bdaad/posturography/README.md

# Posturography

ESP32 と 4 個の AD7193 から、重心動揺計の 4 チャンネル生データを取得するためのコード一式です。  
装置側では `ch1,ch2,ch3,ch4` 形式の CSV 行を出力し、PC 側ではサンプリング確認と校正用データ取得を行います。

## 目次

- [Posturography](#posturography)
  - [目次](#目次)
  - [構成](#構成)
  - [基板画像](#基板画像)
  - [装置側コード](#装置側コード)
  - [Arduino ファイルと通信方式](#arduino-ファイルと通信方式)
  - [データ受信方法](#データ受信方法)
    - [VS Code で見る](#vs-code-で見る)
    - [Arduino IDE で見る](#arduino-ide-で見る)
    - [Python で見る](#python-で見る)
    - [Bluetooth で見る](#bluetooth-で見る)
    - [BLE で受信する](#ble-で受信する)
  - [Python 環境](#python-環境)
  - [サンプリング確認](#サンプリング確認)
  - [校正手順](#校正手順)
  - [校正スクリプトの出力](#校正スクリプトの出力)
  - [校正後の確認](#校正後の確認)
  - [重心位置計算について](#重心位置計算について)
  - [トラブルシュート](#トラブルシュート)
    - [COM ポートが表示されない](#com-ポートが表示されない)
    - [データが取得できない](#データが取得できない)
    - [校正結果が不安定](#校正結果が不安定)

## 構成

| パス | 内容 |
| --- | --- |
| `ad7193_wired/ad7193_wired.ino` | USB シリアルで 4 チャンネルの AD7193 生コードを送信する ESP32 用スケッチ |
| `ad7193_wireless/ad7193_wireless.ino` | USB シリアルに加えて Bluetooth Classic SPP でも同じ CSV 行を送信する ESP32 用スケッチ |
| `BLE_ad7193/BLE_ad7193.ino` | `BLEDevice.h` を使って BLE Notify で AD7193 データを送信する ESP32 用スケッチ |
| `BLE_ad7193/ble_receive.py` | BLE Notify を受信して CSV 保存する Python スクリプト |
| `BLE_ad7193/ble_sampling_test.py` | BLE Notify の受信サンプリングレートを確認する Python スクリプト |
| `BLE_ad7193/README.md` | BLE 版の使い方 |
| `sampling_test.py` | シリアル受信のサンプル数を 1 秒ごと、10 秒ごとに表示する確認用スクリプト |
| `circuit.png` | 配線・回路の参考画像 |
| `calibration/calibration.py` | 校正用に一定数のサンプルを取得し、CSV、統計 JSON、サマリ TXT、ヒストグラム PNG を保存するスクリプト |
| `calibration/calibration.xlsx` | 各重量の `Baseline median` を入力して、各センサーの校正式を作るための Excel ファイル |
| `calibration/README.md` | 校正フォルダ単体で参照するための詳細 README |
| `calibration/calibration.png` | 校正に関する参考画像 |

## 基板画像

配線・回路を確認するときは、以下の基板画像を参照してください。

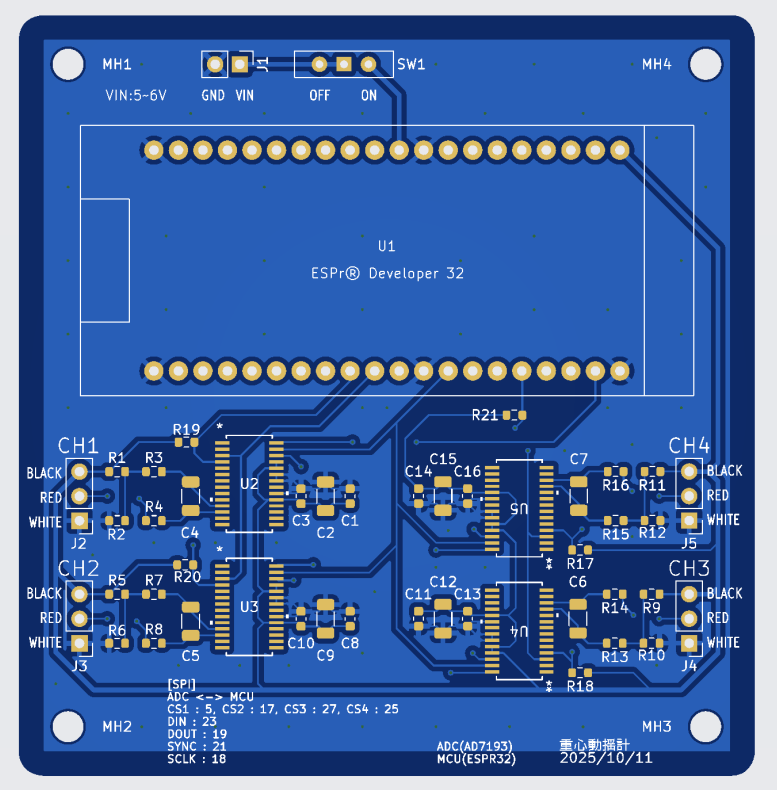
[picture p1: circuit.png]
基板画像


## 装置側コード

基本の校正では `ad7193_wired/ad7193_wired.ino` を使用します。  
Bluetooth Classic SPP で受信したい場合は `ad7193_wireless/ad7193_wireless.ino`、BLE で受信したい場合は `BLE_ad7193/BLE_ad7193.ino` を ESP32 に書き込みます。

共通の主な設定は以下です。

- ボーレート: `115200`
- 出力形式: `ch1,ch2,ch3,ch4`
- AD7193: 4 チップ構成
- AD7193 の目標データレート: 約 `100.1 Hz`
- SPI: `1 MHz`, `MODE3`
- ESP32 側ピン:
  - `MISO`: 19
  - `MOSI`: 23
  - `SCLK`: 18
  - `SYNC`: 21
  - `CS1`: 5
  - `CS2`: 17
  - `CS3`: 27
  - `CS4`: 25

`ad7193_wireless.ino` は Bluetooth Classic SPP のデバイス名 `ESP32-AD7193` で起動します。PC やスマートフォンから Bluetooth SPP として接続すると、USB シリアルと同じ CSV 行を受信できます。  
`BLE_ad7193.ino` は BLE デバイス名 `ESP32-AD7193-BLE` で起動します。BLE は COM ポートではなく、`BLE_ad7193/ble_receive.py` で Notify を受信します。

## Arduino ファイルと通信方式

今後 Arduino 側コードが増える可能性があるため、PC 側スクリプトと対応する `.ino` はここで確認してください。  
現在の対応は以下です。

| Arduino ファイル | 通信方式 | 校正での使用 | `sampling_test.py` | `calibration.py` | 手動確認 |
| --- | --- | --- | --- | --- | --- |
| `ad7193_wired/ad7193_wired.ino` | USB シリアル | 推奨 | 対応 | 対応 | Arduino IDE / VS Code のシリアルモニターで確認可能 |
| `ad7193_wireless/ad7193_wireless.ino` | USB シリアル + Bluetooth Classic SPP | USB 接続なら使用可能。Bluetooth は確認向け | 対応 | OS が Bluetooth SPP をシリアルポートとして認識すれば使用可能 | Arduino IDE / VS Code / Bluetooth SPP 対応アプリで確認可能 |
| `BLE_ad7193/BLE_ad7193.ino` | USB シリアル + BLE Notify | BLE は確認・開発向け。安定した校正は USB 推奨 | USB シリアル出力は確認可能 | BLE 入力は非対応。USB シリアル出力なら既存方式で確認可能 | USB Serial は Arduino IDE / VS Code、BLE は `BLE_ad7193/ble_receive.py` で確認 |

校正では通信の安定性を優先するため、基本は `ad7193_wired/ad7193_wired.ino` を ESP32 に書き込み、USB シリアルで取得してください。  
`ad7193_wireless/ad7193_wireless.ino` は Bluetooth Classic SPP の確認、`BLE_ad7193/BLE_ad7193.ino` は BLE Notify の確認や開発に使えます。

USB シリアルと Bluetooth Classic SPP の受信データの基本形式は同じです。

```text
ch1,ch2,ch3,ch4
```

起動直後は `AD7193 ID` や `AD7193 MODE` などのデバッグ行も出ます。  
`calibration.py` は `4 つの整数がカンマ区切りになっている行` だけをデータとして使い、デバッグ行は無視します。

BLE 版は Notify payload を 20 byte に収めるため、BLE 通知だけは `sample_index,DAT1,DAT2,DAT3,DAT4` 相当の little-endian `uint32` x 5 のバイナリフレームで送信します。`BLE_ad7193/ble_receive.py` が CSV に変換します。

## データ受信方法

最初は Python を動かす前に、シリアルモニターでデータが見えるか確認すると安全です。  
速度設定は `115200 bps` にします。

### VS Code で見る

1. VS Code に `Serial Monitor` 拡張機能を入れる。
2. ESP32 を USB ケーブルで PC に接続する。
3. VS Code の Serial Monitor 画面を開く。
4. `Port` で ESP32 のポートを選ぶ。
   - Windows 例: `COM3`, `COM4`
   - macOS 例: `/dev/cu.usbserial-*`, `/dev/cu.SLAB_USBtoUART`, `/dev/cu.wchusbserial*`
5. `Baud Rate` を `115200` にする。
6. `Start Monitoring` を押す。
7. 以下のような 4 つの数値がカンマ区切りで流れれば受信できています。

```text
8389210,8388750,8389021,8388601
8389208,8388749,8389020,8388602
```

### Arduino IDE で見る

1. ESP32 を USB ケーブルで PC に接続する。
2. Arduino IDE の `ツール` から ESP32 のポートを選ぶ。
3. シリアルモニタを開く。
4. 速度を `115200 baud` にする。
5. `ch1,ch2,ch3,ch4` 形式のデータが流れることを確認する。

### Python で見る

サンプリング数まで確認したい場合は、上位フォルダで以下を実行します。

```bash
cd /Users/gyobu/Documents/weight_measurement/posturography
python3 sampling_test.py
```

ポート一覧が表示されるので、ESP32 の番号を入力してください。  
1 秒ごとのサンプル数が表示されれば、Python からも受信できています。

### Bluetooth で見る

Bluetooth を使う場合は `ad7193_wireless/ad7193_wireless.ino` を書き込みます。

1. ESP32 を起動する。
2. PC またはスマートフォンで `ESP32-AD7193` にペアリングする。
3. PC 側で Bluetooth SPP のシリアルポートが作成されていることを確認する。
4. VS Code、Arduino IDE、または Python スクリプトでそのポートを選ぶ。
5. 速度設定が必要な場合は `115200` にする。

Bluetooth SPP は OS によってポート名や扱いが変わります。校正データを確実に取りたい場合は USB シリアル接続を使ってください。

Windows で Bluetooth Classic SPP を COM ポートとして使う場合、受信データが欠落することがあります。取りこぼしが出る場合は、デバイスマネージャーから対象 COM ポートの詳細設定を開き、FIFO の `受信バッファ` を小さくする設定も試してください。参考: [WindowsのRS-232Cシリアル通信で受信データに欠落が発生する](https://gabekore.org/windows-rs232c-deficit-recv-data)

シリアルポートは基本的に同時に 1 つのアプリからしか開けません。VS Code や Arduino IDE のシリアルモニターで確認したあとに `sampling_test.py` や `calibration.py` を使う場合は、先にシリアルモニターを閉じてください。

### BLE で受信する

BLE を使う場合は `BLE_ad7193/BLE_ad7193.ino` を ESP32 に書き込みます。BLE は Bluetooth Classic SPP と違い、OS 上の COM ポートとしては扱いません。

```bash
cd /Users/gyobu/Documents/weight_measurement/posturography/BLE_ad7193
pip install bleak
python3 ble_receive.py
```

`ble_receive.py` は `ESP32-AD7193-BLE` をスキャンして接続し、BLE Notify を受信して CSV に保存します。詳しくは `BLE_ad7193/README.md` を参照してください。

受信レートだけを確認したい場合は以下を使います。

```bash
python3 ble_sampling_test.py
```

BLE ではデータが落ちることがあります。実機確認では `total=3501` 付近で `index_drops=65` 程度の欠落が出た例があります。10 秒平均はおおよそ `92.5 Hz` から `98.9 Hz` でしたが、完全な連続受信ではありません。校正など欠落が困る測定では USB シリアル版を使ってください。

## Python 環境

PC 側スクリプトは Python で実行します。必要な主なライブラリは以下です。

- `pyserial`
- `numpy`
- `matplotlib`
- `bleak`（BLE 版の `BLE_ad7193/ble_receive.py` を使う場合）

例:

```bash
cd /Users/gyobu/Documents/weight_measurement/posturography
python3 -m venv .venv
source .venv/bin/activate
pip install pyserial numpy matplotlib
# BLE_ad7193/ble_receive.py も使う場合
pip install bleak
```

既に使用している Python 環境がある場合は、その環境で `pyserial`, `numpy`, `matplotlib` が使えれば問題ありません。

## サンプリング確認

ESP32 に装置側コードを書き込み、PC と接続してから実行します。

```bash
cd /Users/gyobu/Documents/weight_measurement/posturography
python3 sampling_test.py
```

実行すると利用可能なシリアルポート一覧が表示されるので、対応する番号を入力します。  
受信できている場合、1 秒間のサンプル数と 10 秒平均が表示されます。終了は `Ctrl + C` です。

装置側コードでは AD7193 の目標データレートを約 `100.1 Hz` に設定していますが、PC 側で実際に受信できている周期はこのスクリプトで確認してください。

## 校正手順

校正では、既存メモに合わせて `ad7193_wired/ad7193_wired.ino` を ESP32 に書き込み、USB ケーブルで PC と接続します。

1. 重心動揺計の中心に重りを置ける状態にする。
2. まず 0 kg の状態にする。
3. `calibration.py` を実行する。
4. 出力された `*_summary.txt` の `Baseline median: [a, b, c, d]` を確認する。
5. `calibration.xlsx` の対応する重量行へ、以下のように入力する。
   - `DAT1`: `Baseline median` の 1 つ目
   - `DAT2`: `Baseline median` の 2 つ目
   - `DAT3`: `Baseline median` の 3 つ目
   - `DAT4`: `Baseline median` の 4 つ目
6. 5 kg, 10 kg, 15 kg ... 50 kg 程度まで同じ処理を繰り返す。
7. Excel 上で各センサーの値と重量の関係を確認し、校正式の係数を求める。

実行例:

```bash
cd /Users/gyobu/Documents/weight_measurement/posturography/calibration
python3 calibration.py
```

`calibration.py` は実行時に以下を対話的に確認します。

- 使用する COM ポート
- 保存する CSV ファイル名
- 計測開始確認: `y` + Enter

取得中は装置を動かさず、USB ケーブルを抜かないでください。ファイル名が既に存在する場合は、末尾に `_1`, `_2` のような番号を付けて保存されます。

## 校正スクリプトの出力

`calibration.py` で `sample.csv` を指定した場合、同じフォルダに以下が保存されます。

| 出力 | 内容 |
| --- | --- |
| `sample.csv` | `DAT1,DAT2,DAT3,DAT4` の 4 列データ |
| `sample_summary.txt` | 使用サンプル数、外れ値数、`Baseline median` などの人間が読むためのサマリ |
| `sample_stats.json` | サマリと同等の情報を機械処理しやすい JSON 形式で保存したもの |
| `sample_hist.png` | 4 チャンネル分の測定値分布ヒストグラム |

現在の `calibration.py` の主な取得条件は以下です。

- 最終的に残すサンプル数: `1600`
- 先頭ドロップ: `40`
- 末尾ドロップ: `40`
- 基準統計を作る最小サンプル数: `120`
- 外れ値判定: median ± MAD ベース
- タイムアウト計算用の目安サンプリング周波数: `80 Hz`

## 校正後の確認

校正式を反映したあと、既知の重りを中心に置き、4 つのセンサーから計算した重量の合計が実際の重りの重量に近いか確認します。  
大きくずれる場合は、以下を確認してください。

- 重りが中心に置かれているか
- 各重量の `Baseline median` を Excel の `DAT1` から `DAT4` に正しい順番で入れているか
- 計測中に装置やケーブルが動いていないか
- サンプリング確認で極端な取りこぼしが出ていないか
- AD7193 の CS ピンとセンサー位置の対応が想定通りか

## 重心位置計算について

このフォルダには、校正後の係数を使って重心位置を連続計算する完成版スクリプトは含まれていません。  
4 センサーから重量を求めたあと、重心位置は装置寸法と各センサー位置に基づいて計算します。既存資料の計算式を使って、各センサー荷重の加重平均として求める想定です。

## トラブルシュート

### COM ポートが表示されない

- ESP32 が PC に接続されているか確認する。
- Arduino IDE のシリアルモニタなど、同じポートを使うアプリを閉じる。
- Bluetooth で使う場合も、OS 側で SPP のシリアルポートとして認識されているか確認する。

### データが取得できない

- ESP32 に正しい `.ino` が書き込まれているか確認する。
- ボーレートが `115200` になっているか確認する。
- `sampling_test.py` で生データ受信の有無を先に確認する。
- Windows の Bluetooth Classic SPP で取りこぼしが出る場合は、COM ポート詳細設定の FIFO `受信バッファ` を小さくする設定も確認する。

### 校正結果が不安定

- 計測中は重りと装置を動かさない。
- 0 kg と各重量で同じ置き方をする。
- `*_hist.png` で値の分布が極端に広がっていないか確認する。
- `*_summary.txt` の外れ値数が多すぎないか確認する。
